dzhang26/1090-receiver-pcb/README.md

# 1090-receiver-pcb
PCB design for the 1.09 GHz mode-A/C/S / ADS-B receiver
