dzhang26/1090-receiver-pcb/(commit log)

2015-05-06 Draft version
    Version 2.0
    [receiver_2v0.brd, receiver_2v0.sch]
2015-05-07 Draft version
    Reorganized schematic, no air wire in the layout
