dzhang26/1090-receiver-pcb/(notices)

Notices in the files:
receiver_2v0.brd:
All Rights Reserved
